AGCACERESR/TEC_LAMP/figures/Balanced bridge.png

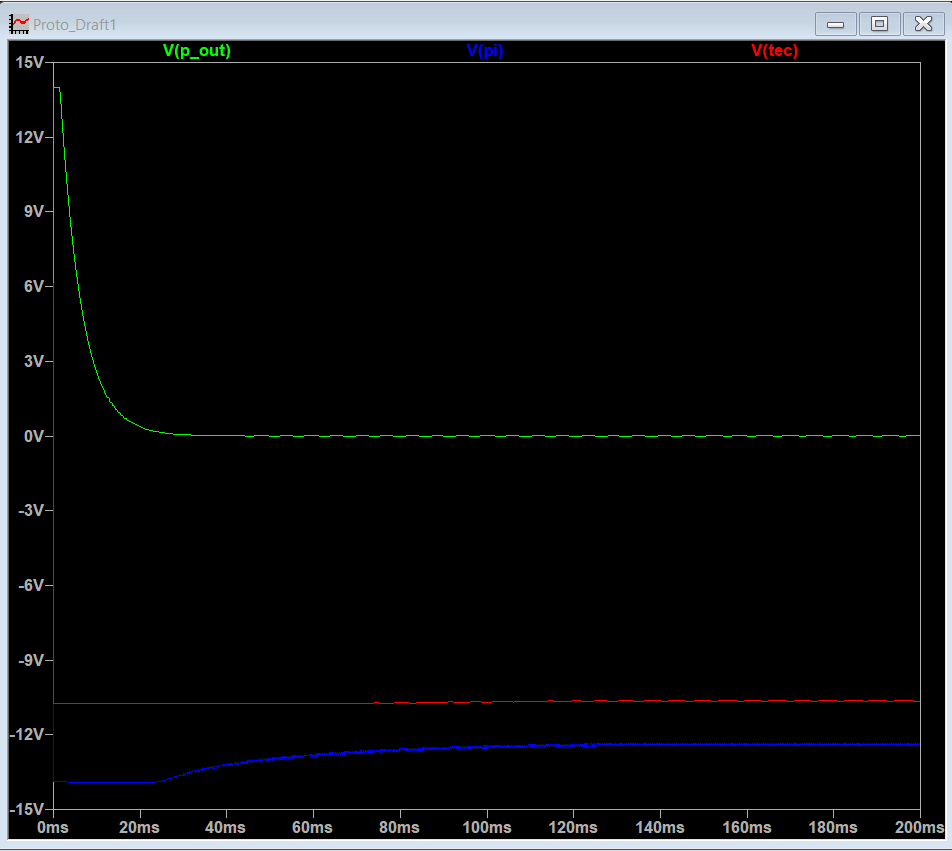
figures/Balanced bridge.png
