AGCACERESR/TEC_LAMP/figures/Thermistor offset.png

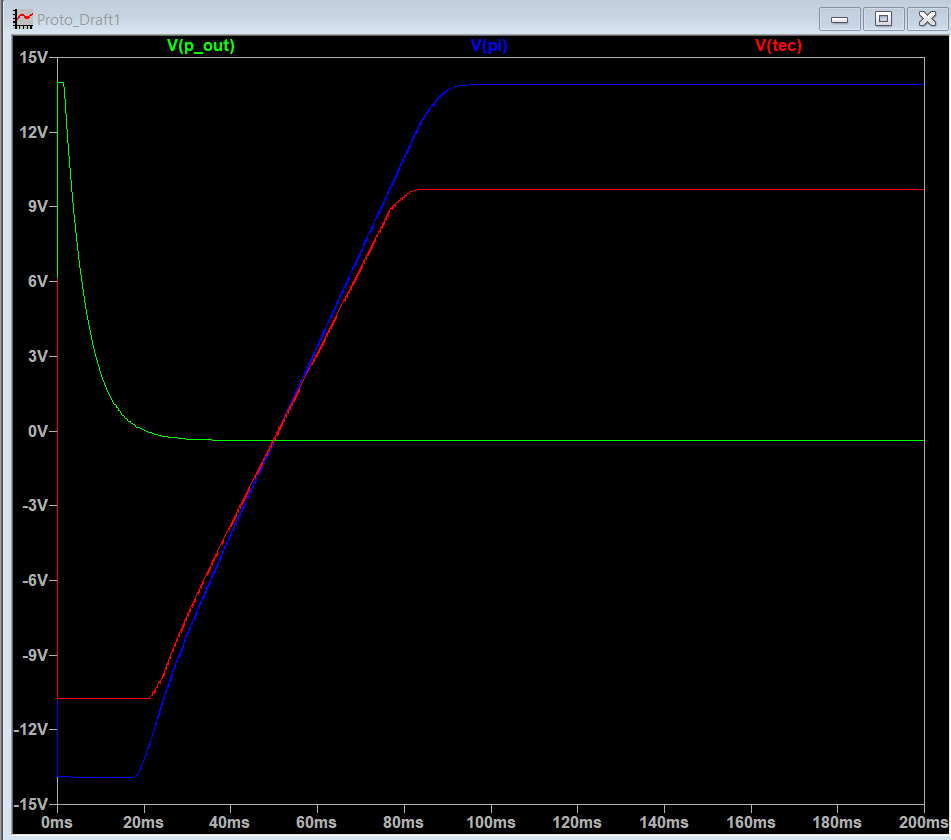
figures/Thermistor offset.png
