AGCACERESR/TEC_LAMP/schematic.pdf

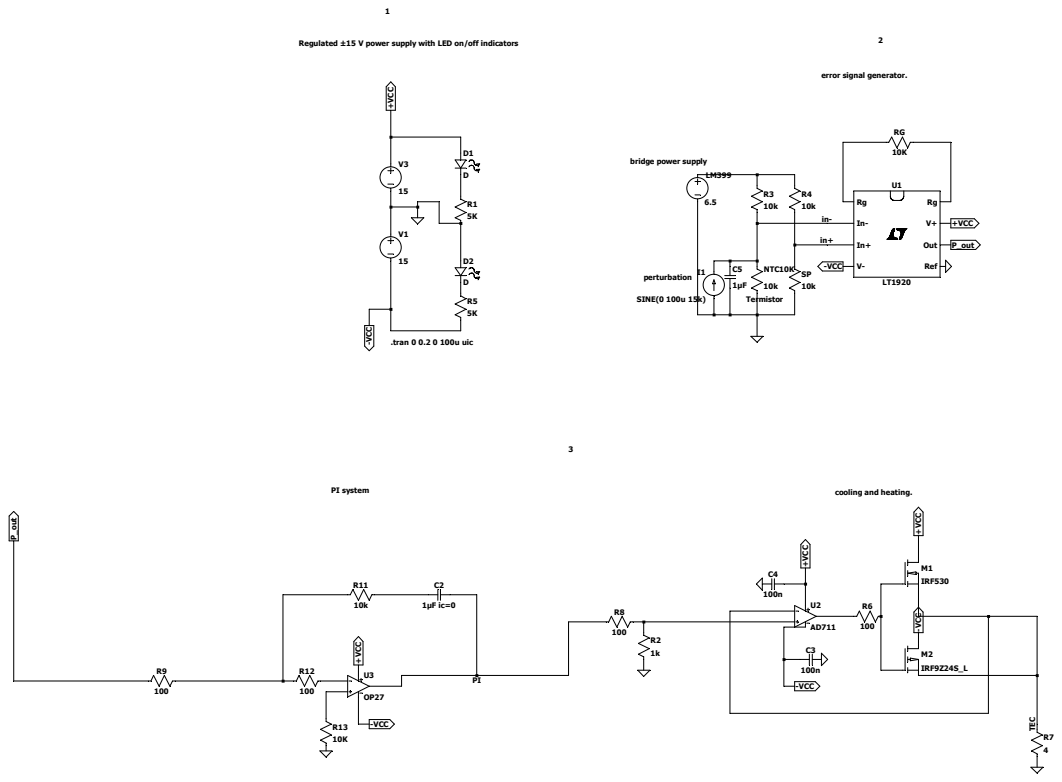
[picture p3: page 1]

Regulated ±15 V power supply with LED on/off indicators
