AGCACERESR/TEC_LAMP/Schematics PCB/LTC_eskeleto}n.pdf

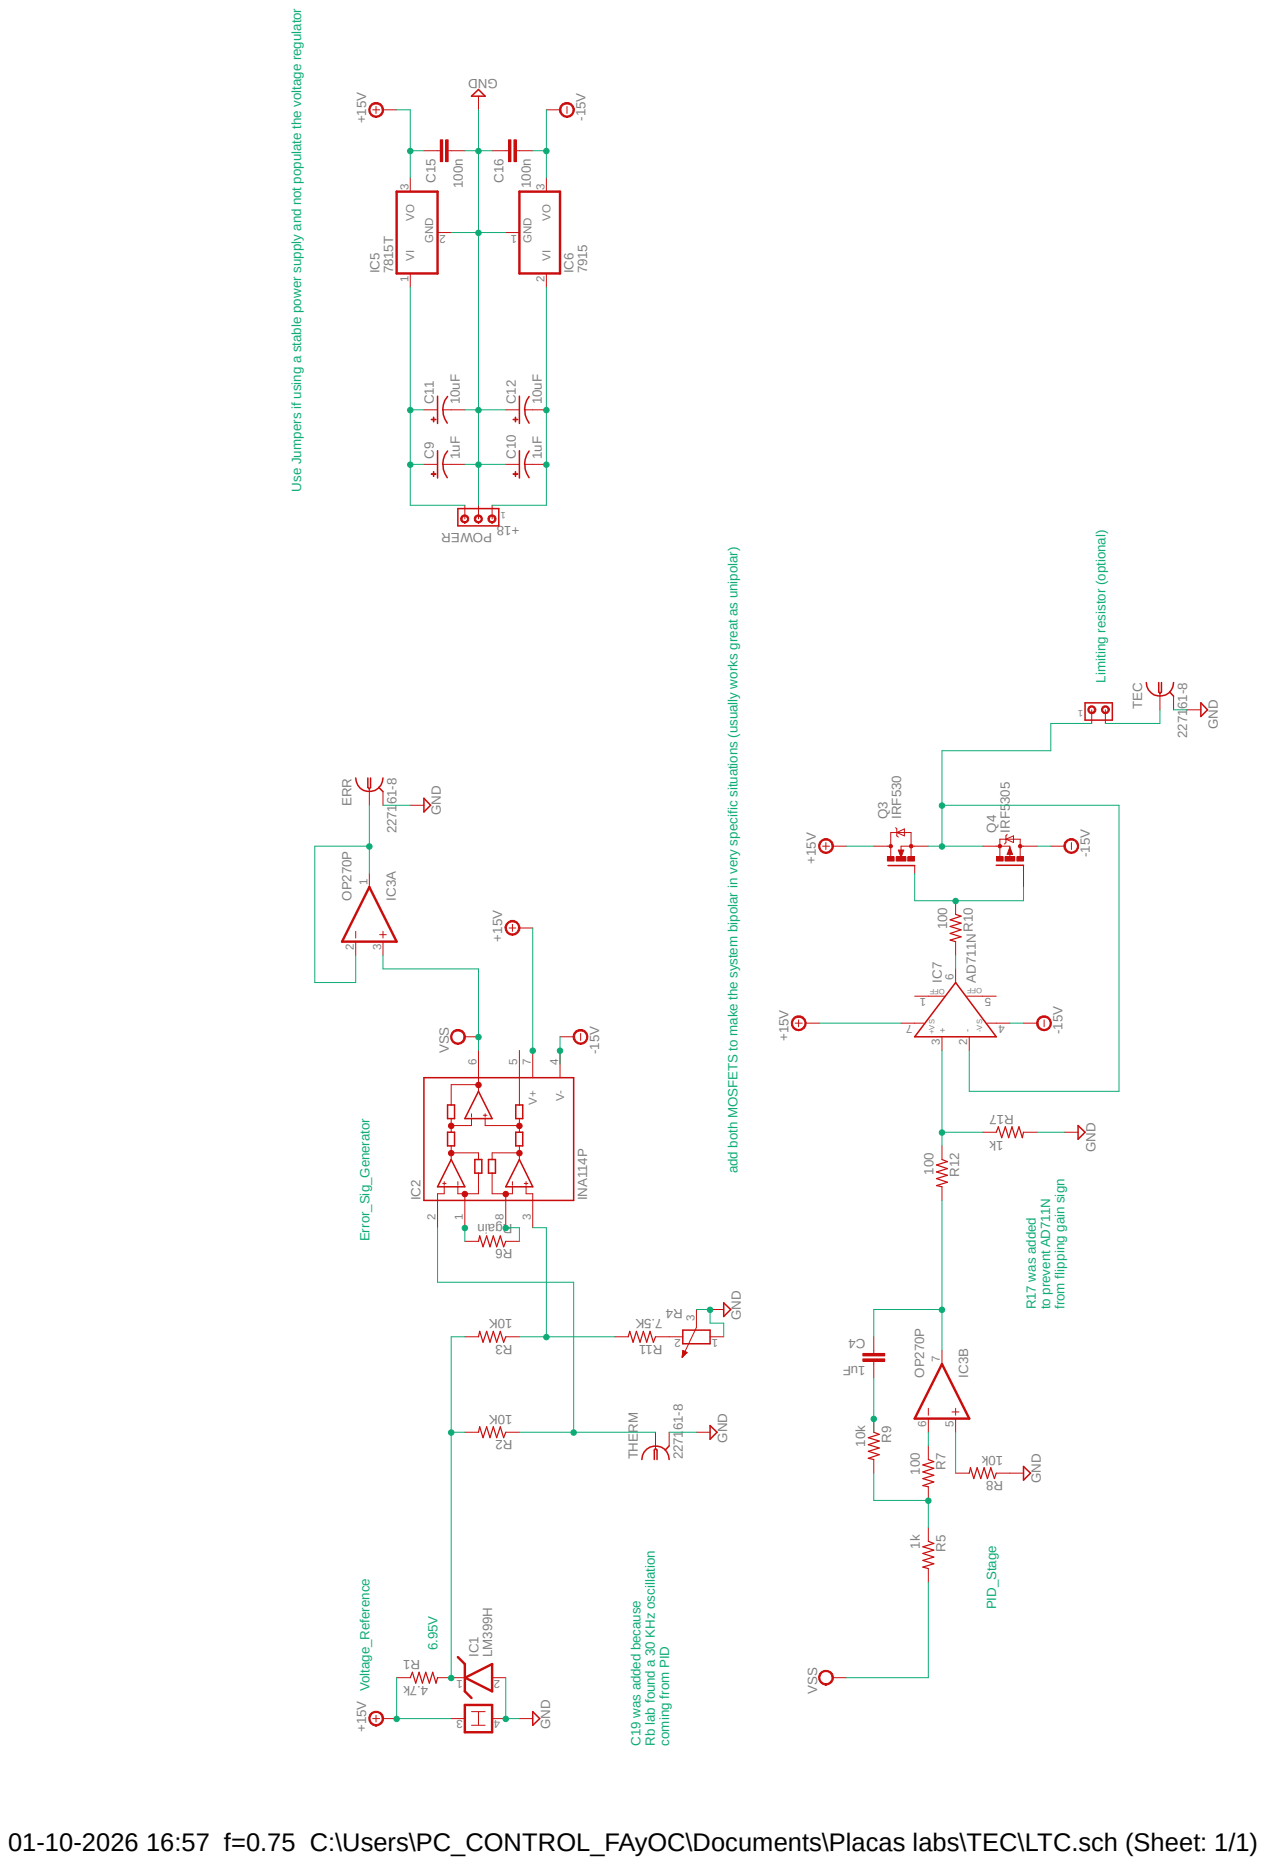
[picture p4: page 1]
