AGCACERESR/TEC_LAMP/simulations/Proto_Draft1.asc

C1: cap; 1µF
C2: cap; 1µ ic=0
C3: cap; 100n
C4: cap; 100n
C5: cap; 1µF
D1: LED
D2: LED
I1: current; SINE(0 100u 15k)
LM399: voltage; 6.5
M1: nmos
M2: pmos
NTC10K: res; 8k
R1: res; 5K
R2: res; 1k
R3: res; 10k
R4: res; 10k
R5: res; 5K
R6: res; 100
R7: res; 1k
R8: res; 100
R9: res; 1K
R10: res; 1K
R11: res; 10k
R12: res; 100
R13: res; 10K
RG: res; 10k
SP: res; 10k
U1: LT1920
U2: AD711
U3: OP27
V1: voltage; 15
V3: voltage; 15
Named nets: 0, +VCC, -VCC, P_out, D, PI, TEC, in+, in-
.tran 0 0.3 0 100u uic
Regulated ±15 V power supply with LED on/off indicators
1
2
3
error signal generator.
Termistor
perturbation
cooling and heating.
bridge power supply
PID system
