AGCACERESR/TEC_LAMP/Schematics PCB/LTC.sch

## EAGLE design Schematics PCB/LTC.sch (2026-10-23)

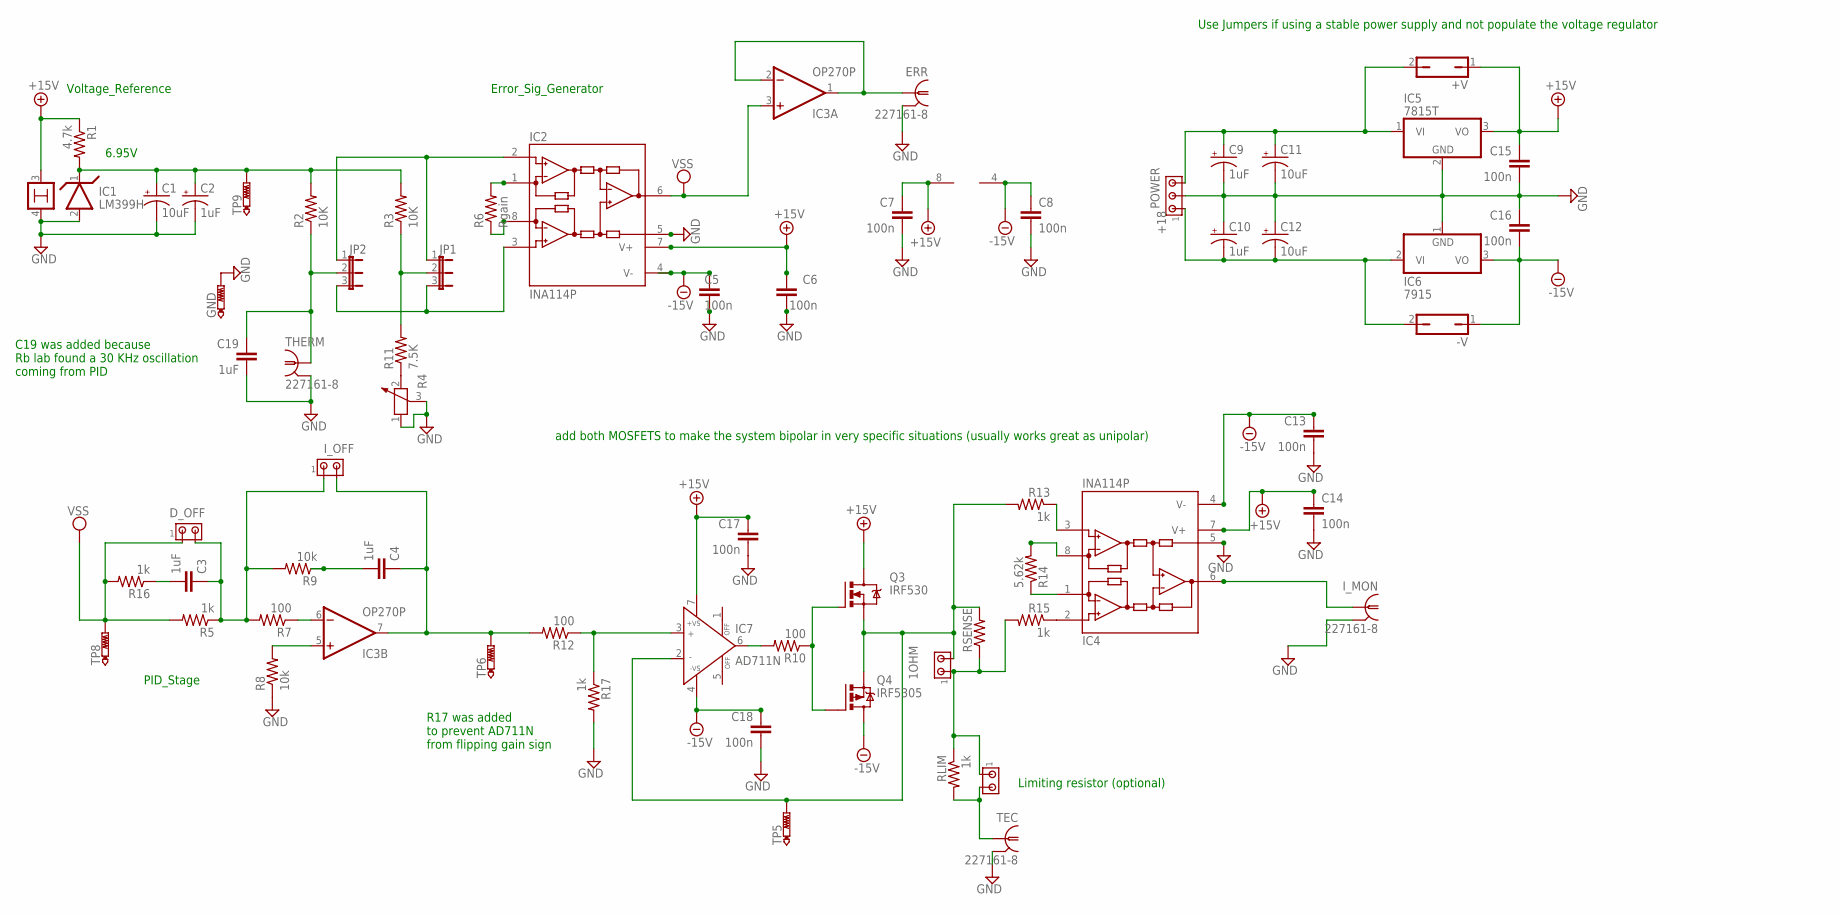
[picture p5: schematic LTC.sch]

Parts:
+V: JP1Q; JP1
-V: JP1Q; JP1
C1, C11, C12: 10uF; SANYO-OSCON_C
C2, C9, C10: 1uF; SANYO-OSCON_A
C3, C4, C19: 1uF; C025-024X044
C5, C6, C7, C8, C13, C14, C15, C16, C17, C18: 100n; C025-024X044
D_OFF: MTA02-100; 10X02MTA
ERR: 227161-8; AMP_227161
GND: PTR1PAD1-13; P1-13
IC1: LM399H; TO39/4
IC2, IC4: INA114P; DIL08
IC3: OP270P; DIL08
IC5: 7815T; TO220H
IC6: 7915; TO220H
IC7: AD711N; DIL08
I_MON: 227161-8; AMP_227161
I_OFF: MTA02-100; 10X02MTA
J1, J3: 1OHM; 10X02MTA
JP1, JP2: JP2E; JP2
POWER: +18; 10X03MTA
Q3: IRF530; TO220BV
Q4: IRF5305; TO220AV
R1: 4.7k; 0207/10
R2, R3: 10K; 0207/10
R4: POTENTIOMETER_PT_SPIN; PT-SPIN
R5, R13, R15, R16, R17: 1k; 0207/10
R6: Rgain; 0207/10
R7, R10, R12: 100; 0207/10
R8, R9: 10k; 0207/10
R11: 7.5K; 0207/10
R14: 5.62k; 0207/10
RLIM: 1k; 0207/10
RSENSE: R-US_0617/17; 0617/17
TEC: 227161-8; AMP_227161
THERM: 227161-8; AMP_227161
TP5, TP6, TP8, TP9: PTR1PAD1-13; P1-13

Connections:
+15V: +V.1, C6.1, C7.1, C14.1, C15.1, C17.1, IC1.3, IC2.7 (V+), IC3.8 (V+), IC4.7 (V+), IC5.3 (VO), IC7.7 (+VS), Q3.D, R1.1
-15V: -V.1, C5.1, C8.1, C13.1, C16.2, C18.1, IC2.4 (V-), IC3.4 (V-), IC4.4 (V-), IC6.3 (VO), IC7.4 (-VS), Q4.C (D)
GND: C1.-, C2.-, C5.2, C6.2, C7.2, C8.2, C9.-, C10.+, C11.-, C12.+, C13.2, C14.2, C15.2, C16.1, C17.2, C18.2, C19.2, ERR.2, GND.TP, IC1.2, IC1.4, IC2.5 (REF), IC4.5 (REF), IC5.2 (GND), IC6.1 (GND), I_MON.2, POWER.2, R4.1, R4.3, R8.1, R17.2, TEC.2, THERM.2
unnamed: IC7.2 (IN-), J3.2, Q3.S, Q4.E (S), R13.2, RSENSE.2, TP5.TP
unnamed: Q3.G, Q4.B (G), R10.1
unnamed: C4.2, R9.1
unnamed: J1.1, J3.1, R15.2, RLIM.1, RSENSE.1
unnamed: IC3.6 (-IN), R7.1
unnamed: ERR.1, IC3.1 (OUT), IC3.2 (-IN)
unnamed: C1.+, C2.+, IC1.1, R1.2, R2.2, R3.2, TP9.TP
unnamed: IC7.3 (IN+), R12.1, R17.1
unnamed: IC2.2 (-IN), JP1.1, JP2.1
unnamed: +V.2, C9.+, C11.+, IC5.1 (VI), POWER.3
unnamed: C3.1, D_OFF.2, I_OFF.1, R5.1, R7.2, R9.2
unnamed: IC3.5 (+IN), R8.2
unnamed: R4.2, R11.1
unnamed: -V.2, C10.-, C12.-, IC6.2 (VI), POWER.1
unnamed: IC7.6 (OUT), R10.2
unnamed: C4.1, IC3.7 (OUT), I_OFF.2, R12.2, TP6.TP
unnamed: C19.1, JP2.2, R2.1, THERM.1
unnamed: IC4.6 (OUT), I_MON.1
unnamed: IC2.3 (+IN), JP1.3, JP2.3
unnamed: C3.2, R16.1
unnamed: J1.2, RLIM.2, TEC.1
unnamed: IC4.2 (-IN), R15.1
unnamed: IC4.3 (+IN), R13.1
unnamed: JP1.2, R3.1, R11.2
unnamed: IC4.8 (RG), R14.2
unnamed: IC4.1 (RG), R14.1
unnamed: IC2.1 (RG), R6.2
unnamed: IC2.8 (RG), R6.1
VSS: D_OFF.1, IC2.6 (OUT), IC3.3 (+IN), R5.2, R16.2, TP8.TP

Notes on the sheet:
Voltage_Reference
PID_Stage
Error_Sig_Generator
Use Jumpers if using a stable power supply and not populate the voltage regulator
add both MOSFETS to make the system bipolar in very specific situations (usually works great as unipolar)
Limiting resistor (optional)
6.95V
C19 was added because Rb lab found a 30 KHz oscillation coming from PID
R17 was added to prevent AD711N from flipping gain sign
